mmd-bsd/bluetooth-shuter/Part1.SLDPRT

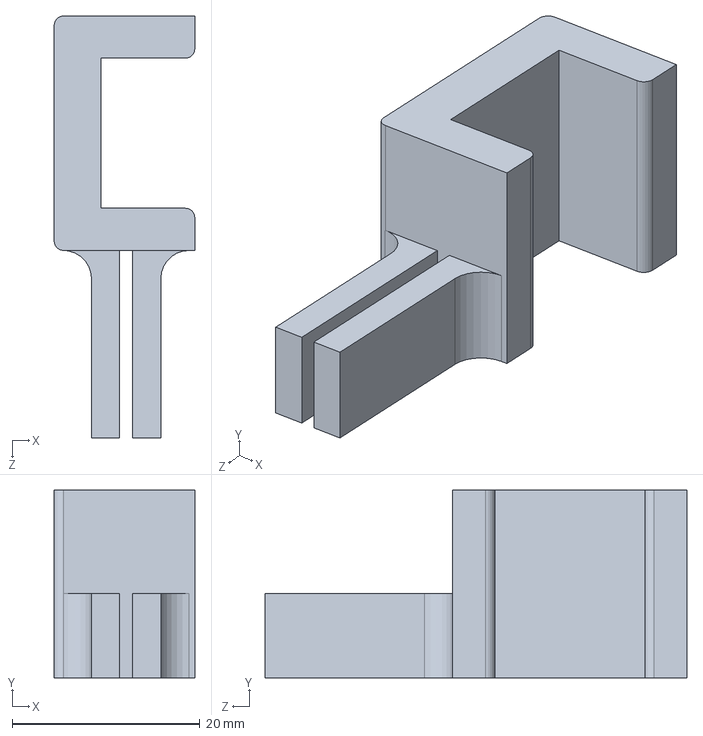
[picture p1: CAD file, 2026-09-13]
Part1.SLDPRT
15.0 x 20.0 x 45.0 mm
