mmd-bsd/bluetooth-shuter/(list of files, cad)

Other CAD files:
Part1.STL
