mmd-bsd/bluetooth-shuter/(commit log)

2026-09-13 Add adjustable self-timer delay before shutter fires
    Adds SHUTTER_DELAY_MS (default 1000ms) so the shot is taken a
    configurable time after the button press, giving time to pose.
    Set to 0 for instant.
    The wait is non-blocking: the press arms a timestamp that loop()
    polls, rather than delaying inside the button handler. That keeps
    the LED running so the countdown is visible, and lets the self-timer
    be cancelled cleanly if the phone disconnects mid-wait.
    Also adds a third LED state (fast blink) for the countdown.
    Verified on hardware: press -> 1000ms countdown -> shutter fires.
2026-09-13 3d parts
    [Part1.SLDPRT, Part1.STL]
